BrandonKakimoto/RP2040_Dev_Board/fabrication/RP2040_Dev_Board_BOM.xlsx

Comment | Designator | LCSC Part # | Footprint | Quantity
15pF | C16, C17 | C1644 | CAPC1608X90X40NL10T20 | 2
RP2040 | U1 | C2040 | QFN40P700X700X90-57N | 1
KT-0603R | D1, D2 | C2286 | FP-SML-D12-MFG | 2
USBLC6-2SC6 | U2 | C7519 | SOT95P280X145-6N | 1
100nF | C1, C2, C4, C6, C7, C8, C9, C11, C12, C13, C15 | C14663 | CAPC1608X90X40NL10T20 | 11
1uF | C10, C14 | C15849 | CAPC1608X90X40NL10T20 | 2
1k | R5, R6, R7, R10 | C21190 | RESC1608X55X25ML10T15 | 4
5.1k | R3, R4 | C23186 | RESC1608X55X25ML10T15 | 2
22R | R1, R2 | C23345 | RESC1608X55X25ML10T15 | 2
10k | R8, R9 | C25804 | RESC1608X55X25ML10T15 | 2
AP2112K-3.3TRG1 | U3 | C51118 | FP-SOT25-IPC_A | 1
10uF | C3, C5 | C15850 | FP-C0805C106K4PACTU-MFG | 2
W25Q128JVSIQ | U4 | C97521 | SOIC127P790X216-8N | 1
1206L050YR | F1 | C163512 | FP-1206L050YR-MFG | 1
TYPE-C-31-M-12 | J1 | C165948 | HRO_TYPE-C-31-M-12 | 1
TS-1187A-B-A-B | SW1, SW2 | C318884 | SW_TS-1187A-B-A-B | 2
ABM8-272-T3 | Y1 | C20625731 | XTAL_ABM8-272-T3 | 1
