BrandonKakimoto/RP2040_Dev_Board/RP2040_Dev_Board.pdf

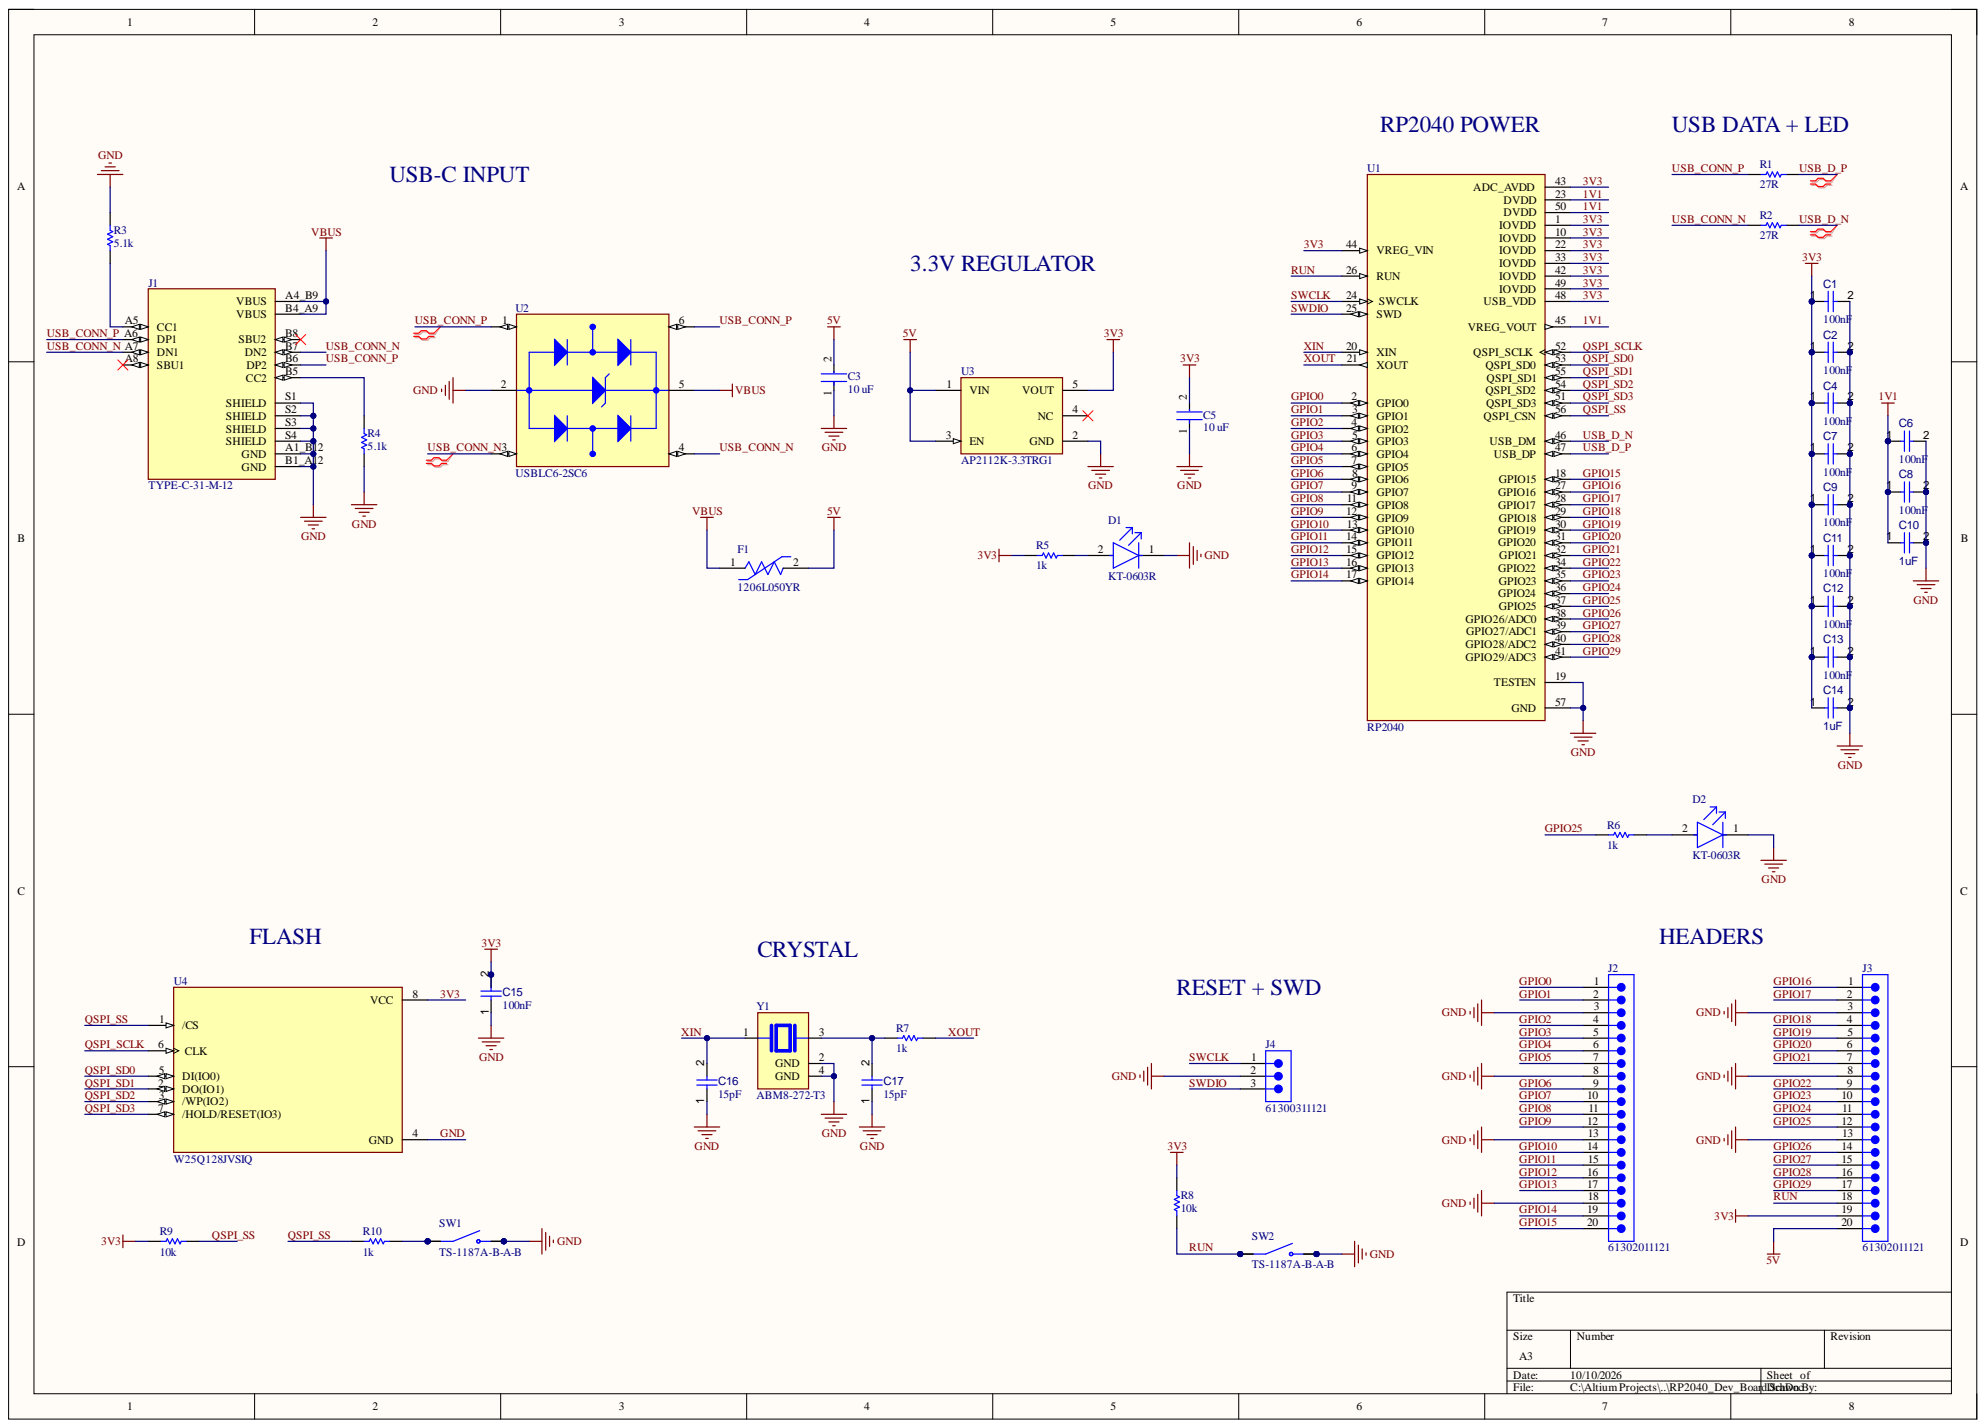
[picture p1: page 1]
