BrandonKakimoto/RP2040_Dev_Board/(list of files, drawings)

Other design files:
RP2040_Dev_Board.PcbDoc
RP2040_Dev_Board.PrjPcb
RP2040_Dev_Board.SchDoc
