BrandonKakimoto/RP2040_Dev_Board/(commit log)

2026-10-11 Schematic Block 1 Completed
2026-10-11 Completed Block 2 Schematic
2026-10-11 Schematic Block 4 Completed
2026-10-11 Schematic Block 5 Completed
2026-10-11 Schematic Block 7 Completed
2026-10-11 Part 3 BOM Completed
2026-10-13 PCB Traces Completed up to crystal
2026-10-13 Most of the routing completed. Need to complete ground vias
2026-10-13 4-layer | New rules | PWR layer | No ground via
2026-10-13 Before placement of ground vias
2026-10-13 All ground vias placed
2026-10-14 Completed PCB Design
2026-10-14 Before LED polarity fix
2026-10-24 Add README, fabrication files, libraries and schematic PDF
2026-10-25 Revise README for RP2040 Development Board
    Updated the README to reflect the RP2040 development board and its features. Added sections on design process, board specifications, and project summaries.
